3D-Printed-Granular-Jamming-Hand/3d-printed-granular-jamming-hand/GranularJammingModels/4nb7b.gif

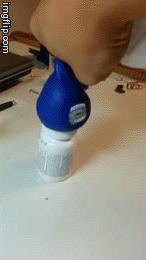
GranularJammingModels/4nb7b.gif
