3D-Printed-Granular-Jamming-Hand/3d-printed-granular-jamming-hand/README.txt

This is a student-driven project in which we develop a 3d printable hand prosthetic, utilizing granular jamming to maintain a firm grip on objects.
