3D-Printed-Granular-Jamming-Hand/3d-printed-granular-jamming-hand/Z OldResearch/Research/Arm Amputation Statistics/README.txt

Statistics on arm amputation-- for background.
