3D-Printed-Granular-Jamming-Hand/3d-printed-granular-jamming-hand/Z OldResearch/Research/Hobbyist Hands/README.txt

This folder contains research on hobbyist hand projects.

HOW TO NAVIGATE THIS FOLDER:

just check out "Hobbyist 3D Printed Hand Websites", and focus most on the 3 biggest players. That should be all you really need for a state-of-the-art analysis of current 3d printed hands.
