3D-Printed-Granular-Jamming-Hand/3d-printed-granular-jamming-hand/ProgressReports/1 Fall Semester/Presentation 1/Old Segments/Technical Analysis.pptx

## Technical Analysis

- Real hand motion
- 3 degrees of freedom
  - Supination/pronation
  - Extension/flexion
  - Ulnar deviation/radial deviation


## Technical Analysis

- 2 degrees of freedom
- Twist and extension/flexion

## Engineering Design

- Motors for fingers
- A digital I/O for signals from sensors and motors
- Granular jamming pad for firm grip

## Engineering Design

- Data when moving fingers
- Signals when moving wrist
- Signals when grabbing objects
