3D-Printed-Granular-Jamming-Hand/3d-printed-granular-jamming-hand/SolidworksModels/Forearm Models/Old/case model/update mar 12.docx

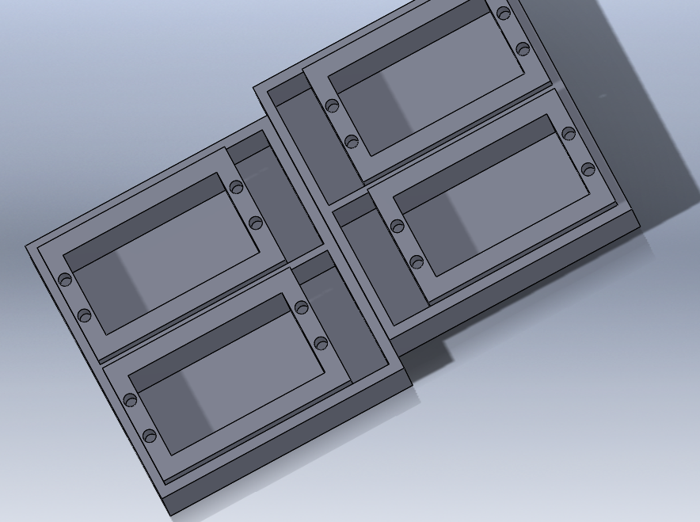
[picture p125: figure]

Servo case+mounting

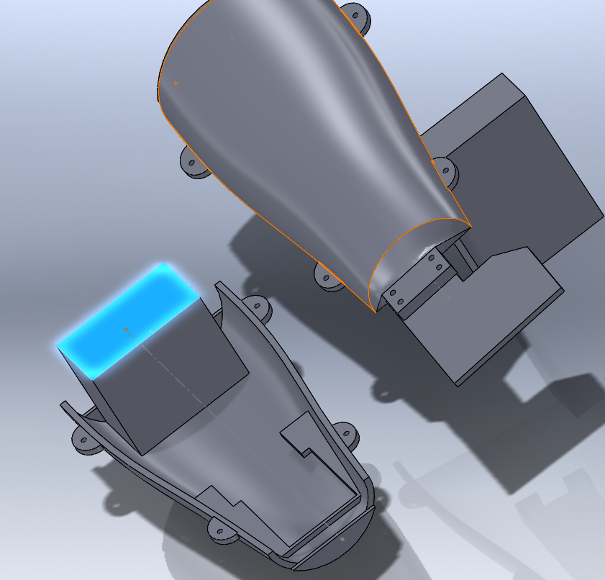
[picture p126: figure]

bottom and top
