3D-Printed-Granular-Jamming-Hand/3d-printed-granular-jamming-hand/Z OldResearch/Research/Air Muscle/Air Muscles.docx

Instructables on how to make an air muscle

http://www.instructables.com/id/How-to-make-air-muscles!/

Company who makes robotics using air muscle

http://www.shadowrobot.com/products/air-muscles/

Controlling a joint with 1 or 2 air muscles

https://www.youtube.com/watch?v=x6d1T210h9M&list=PL2dIrTE5UGCl7MQHjFtq9gGOiKrizbiVy

Screwing in a light bulb and unscrewing with air muscles

http://www.youtube.com/watch?v=dKHd2Wm_YyQ

Controlling an air muscle using EMG

https://www.youtube.com/watch?v=St9fjxKYR5g&list=PL2dIrTE5UGCl7MQHjFtq9gGOiKrizbiVy

https://www.youtube.com/watch?v=AkaVsoEd6Vo
