3D-Printed-Granular-Jamming-Hand/3d-printed-granular-jamming-hand/Z OldResearch/Research/Arm Amputation Statistics/prosthetic background.pptx

## Prosthesis: Definition

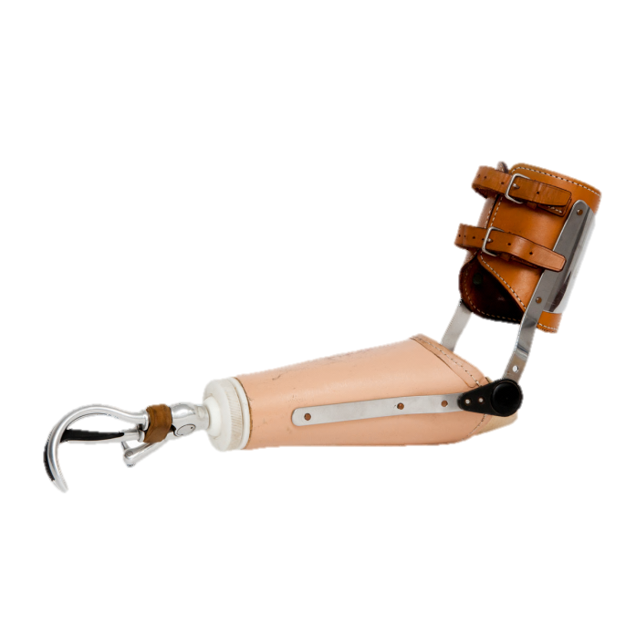
[picture p128: figure]

- An artificial device that replaces a missing body part
- These devices work with muscle, skeleton, and (more recently) the nervous system to enhance motor control
- Prosthetics can be used to replace a variety of body parts including but not limited to arms, legs, teeth, eyes, or heart valves

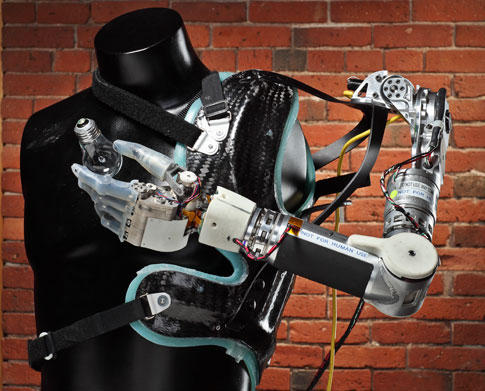
[picture p129: figure]

## History

- Prostheses date back to the ancient Egyptians and Greeks
  - Earliest mention of an artificial limb was around 500 B.C.
  - An artificial limb made of wood and copper dating back to 300 B.C. was found at Capri, Italy in 1858
  - During the Dark ages, debilitated knights would use prosthetics after losing limbs in battle.
- Functional prosthetics began to become introduced more and more with new developments of Ambroise Paré in amputation surgery in the 1500s.
  - Ambroise Paré , a French Army barber/surgeon, is considered the father of modern amputation surgery and prosthetic design.

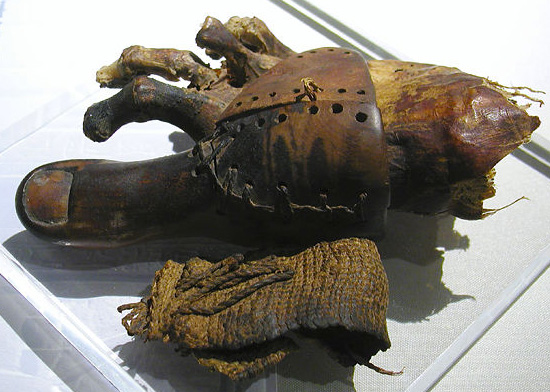
[picture p130: figure]

## History

- As time passed and technology became more advanced, prosthetics became more functional and intricate.

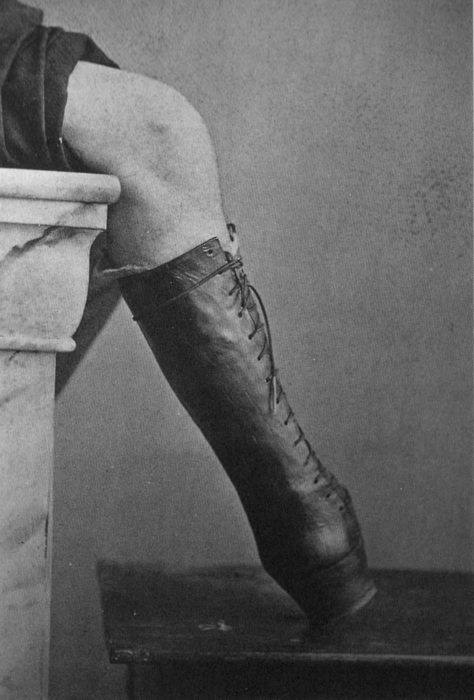
[picture p131: figure]
Prosthetic boot 1865
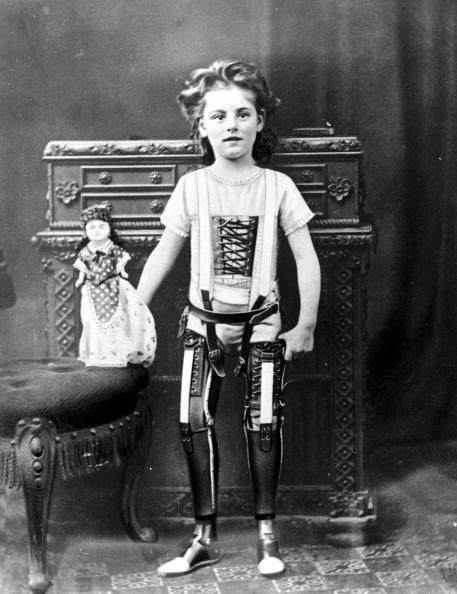
[picture p132: figure]
Studio photo of a young girl wearing a pair of artificial legs, ~ 1900. The legs were manufactured by James Gillingham, a boot- and shoemaker based in Chard, Somerset.
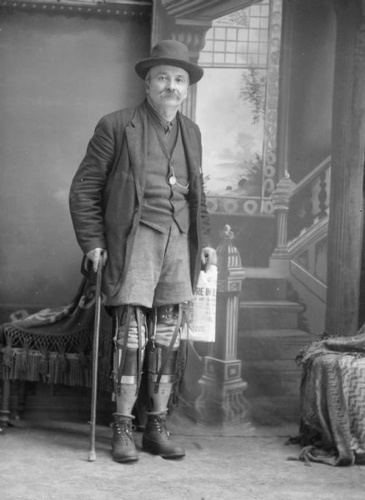
[picture p133: figure]
William Tennant with Prosthetic Legs by Wisconsin Historical Images, via Flickr

## Traditional Prosthesis

- Traditional prosthesis are not permanent
- They are attached to the body using a number of methods, all of which allow for easy removal
- The system of attachment is called the suspension system

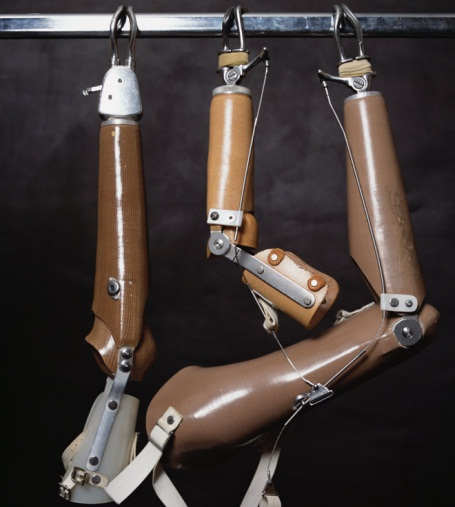
[picture p134: figure]
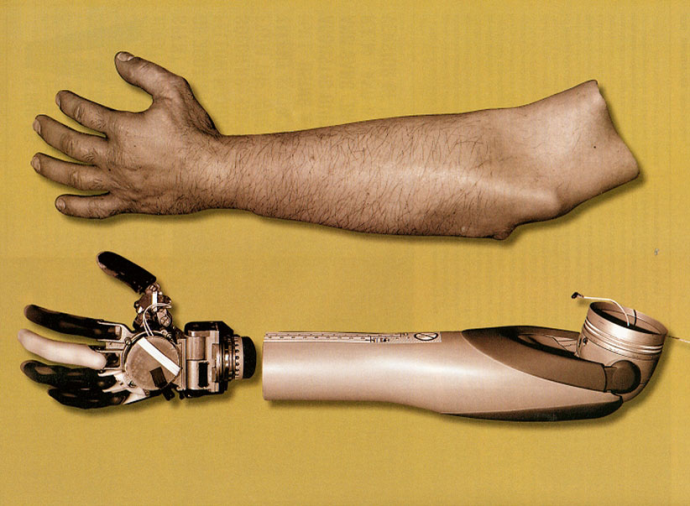
[picture p135: figure]
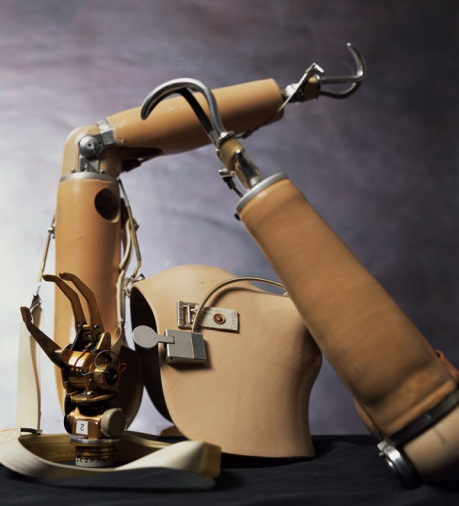
[picture p136: figure]

## Existing Suspension Systems

- Adjustable Sleeve
  - Achieves fit through a strap/buckle
  - Used in temporary situations, such as when the user’s body is adjusting to limb loss
- Elastic Sleeve
  - Sleeve covers the patient’s stump
  - Uses friction/slight vacuum to keep limb in place
  - Utilizes Silicone gel for a more comfortable fit
- Suction Socket
  - Creates vacuum between body and prosthesis
  - Artificial Limb can be taken on and off by opening a one-way valve
  - Better for blood flow

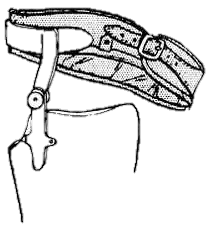
[picture p137: figure]
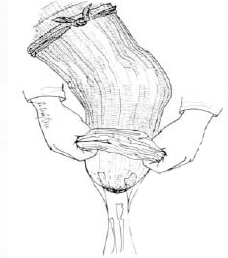
[picture p138: figure]
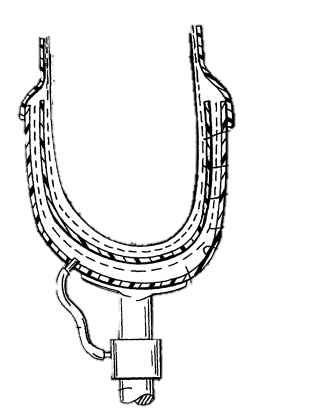
[picture p139: figure]

## Downside & Limitations of Traditional Prosthesis

- No direct connection to the body
  - There is no interface between human and limb
  - This means that complex control is impossible
- Waste of energy
  - It takes about 80% more energy to walk with an above the knee prosthetic than it takes for an able-bodied person
  - This makes walking very tiring
- Sweat causes irritation due to lack of airflow
  - This can cause skin rashes, blisters, and tissue breakdown
  - This irritation can also cause the stump to change size, changing fit
- Temporary
  - Traditional prosthetics have a short lifespan, and need to be replaced every few years
