3D-Printed-Granular-Jamming-Hand/3d-printed-granular-jamming-hand/ProgressReports/1 Fall Semester/Presentation 1/Old Segments/Matricies_CW.xlsx

Category: | Simplicity | Affordability | Feasability | Totals:
Category Weight: | 10 | 8 | 9
Item:
Balloon | 8 | 10 | 7 | 223
Silicone | 9 | 9 | 8 | 234
Category: | Simplicity | Affordability | Feasability | Totals:
Category Weight: | 10 | 8 | 9
Item:
Interconnected | 9 | 8 | 7 | 217
Individual | 5 | 6 | 3 | 125
Category: | Simplicity | Performance | Feasability | Totals:
Category Weight: | 10 | 9 | 9
Item:
Pad for 1 | 9 | 5 | 7 | 198
Pad for 1,2,&3 | 6 | 8 | 5 | 177
Pads on 1 & 3 | 8 | 7 | 7 | 206
