3D-Printed-Granular-Jamming-Hand/3d-printed-granular-jamming-hand/SCADModels/Purchased/README.txt

This folder contains all the models/keepaways/etc for parts that will be purchased and need to fit into the printed parts.
