3D-Printed-Granular-Jamming-Hand/3d-printed-granular-jamming-hand/SolidworksModels/Forearm Models/top.SLDASM

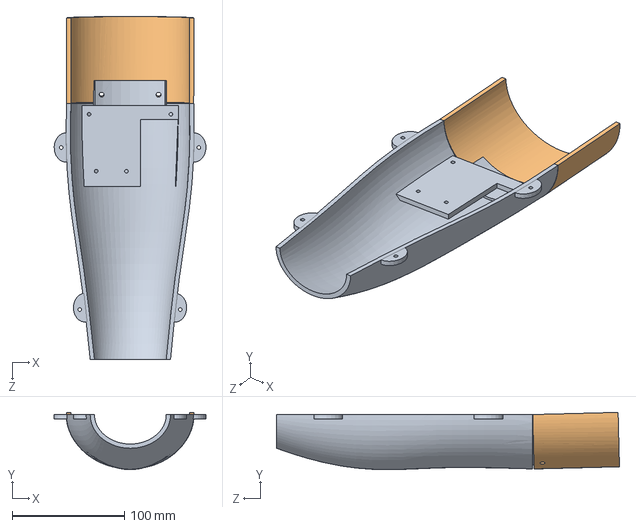
[picture p140: CAD file, 2014-05-27]
SolidworksModels/Forearm Models/top.SLDASM
135.4 x 51.1 x 306.0 mm
Top
Top1
