3D-Printed-Granular-Jamming-Hand/3d-printed-granular-jamming-hand/SolidworksModels/Forearm Models/Bottom.SLDASM

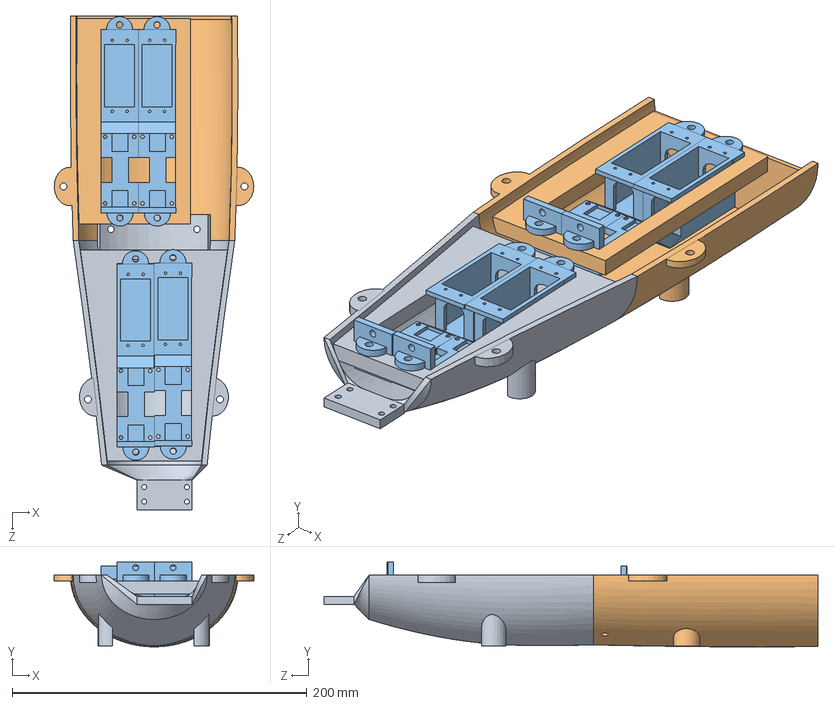
[picture p141: CAD file, 2014-05-27]
SolidworksModels/Forearm Models/Bottom.SLDASM
135.5 x 57.6 x 335.3 mm
bottom2
bottom
servo case x 4
