3D-Printed-Granular-Jamming-Hand/3d-printed-granular-jamming-hand/SolidworksModels/Servo Hubs/HubsAtRelativeHeights.SLDASM

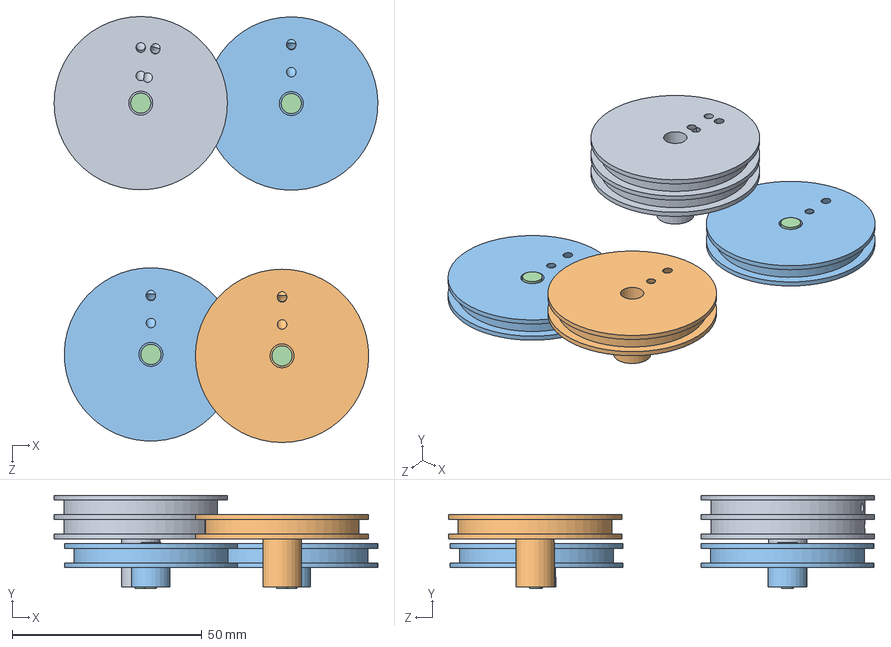
[picture p142: CAD file, 2014-05-09]
SolidworksModels/Servo Hubs/HubsAtRelativeHeights.SLDASM
85.4 x 24.6 x 112.4 mm
Hub3
Hub2
Hub1 x 2
ServoHubBolt x 4
