3D-Printed-Granular-Jamming-Hand/3d-printed-granular-jamming-hand/SCADModels/Printed/Hand8.0_fixed.stl

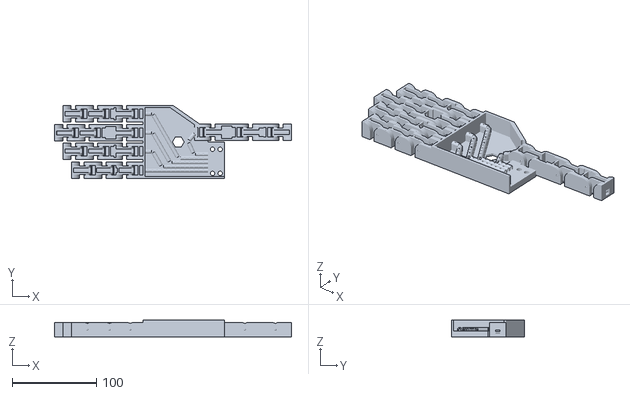
[picture p143: CAD file, 2014-05-09]
SCADModels/Printed/Hand8.0_fixed.stl
281.8 x 87.0 x 19.8
