3D-Printed-Granular-Jamming-Hand/3d-printed-granular-jamming-hand/SolidworksModels/Forearm Models/bottom2.SLDPRT

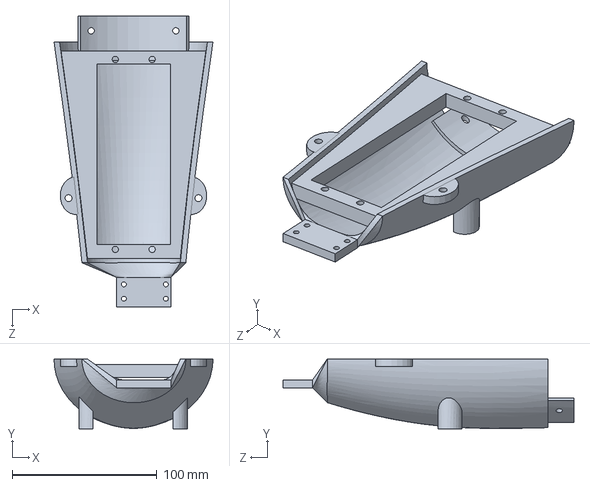
[picture p144: CAD file, 2014-05-27]
SolidworksModels/Forearm Models/bottom2.SLDPRT
109.7 x 48.3 x 200.7 mm
