3D-Printed-Granular-Jamming-Hand/3d-printed-granular-jamming-hand/SolidworksModels/Servo Hubs/Hub3-fixed.SLDPRT

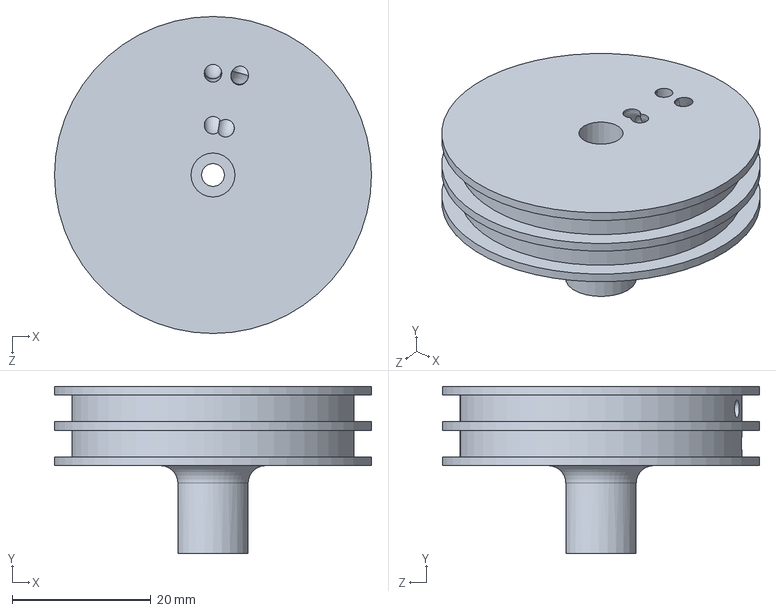
[picture p145: CAD file, 2014-05-27]
SolidworksModels/Servo Hubs/Hub3-fixed.SLDPRT
45.7 x 24.1 x 45.7 mm
