3D-Printed-Granular-Jamming-Hand/3d-printed-granular-jamming-hand/SolidworksModels/Servo Hubs/Hub1-fixed.SLDPRT

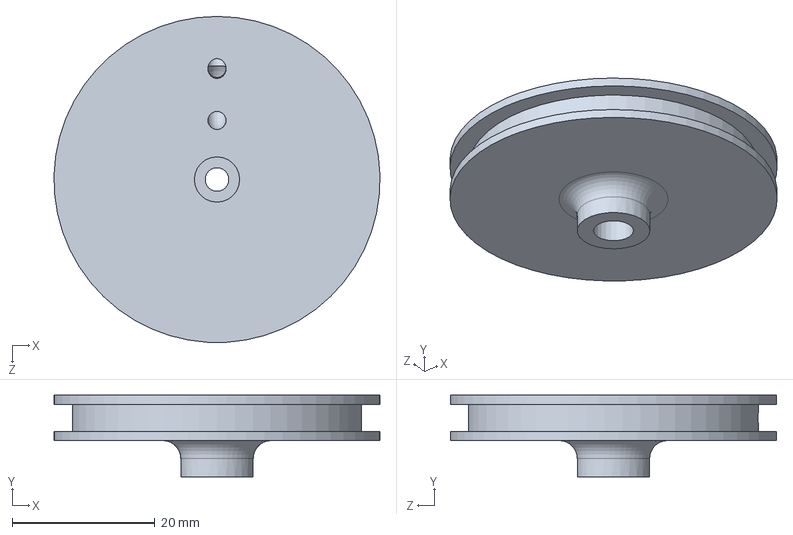
[picture p146: CAD file, 2014-05-27]
SolidworksModels/Servo Hubs/Hub1-fixed.SLDPRT
45.7 x 11.4 x 45.7 mm
