3D-Printed-Granular-Jamming-Hand/3d-printed-granular-jamming-hand/SolidworksModels/Forearm Models/Top1.SLDPRT

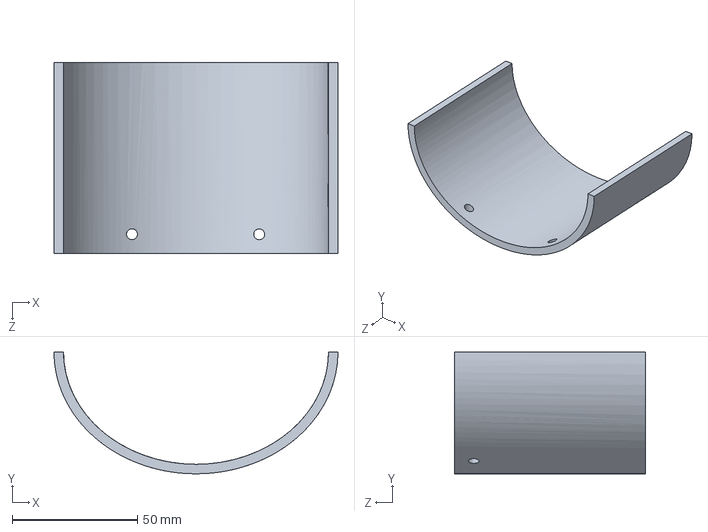
[picture p147: CAD file, 2014-05-27]
SolidworksModels/Forearm Models/Top1.SLDPRT
113.4 x 48.6 x 76.2 mm
