3D-Printed-Granular-Jamming-Hand/3d-printed-granular-jamming-hand/SolidworksModels/Servo Hubs/Hub2-fixed.SLDPRT

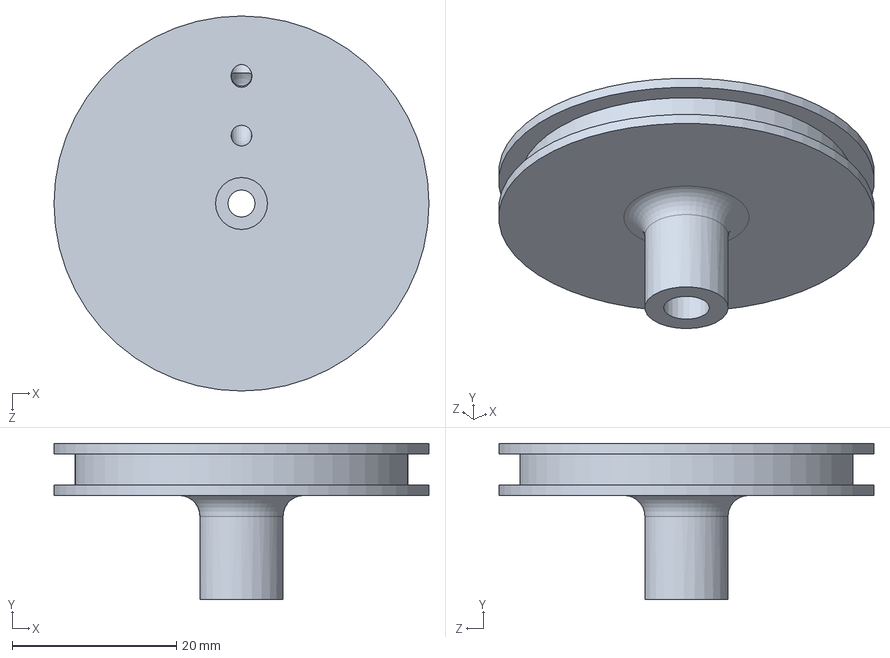
[picture p148: CAD file, 2014-05-27]
SolidworksModels/Servo Hubs/Hub2-fixed.SLDPRT
45.7 x 19.0 x 45.7 mm
