3D-Printed-Granular-Jamming-Hand/3d-printed-granular-jamming-hand/SolidworksModels/Forearm Models/servo case.SLDPRT

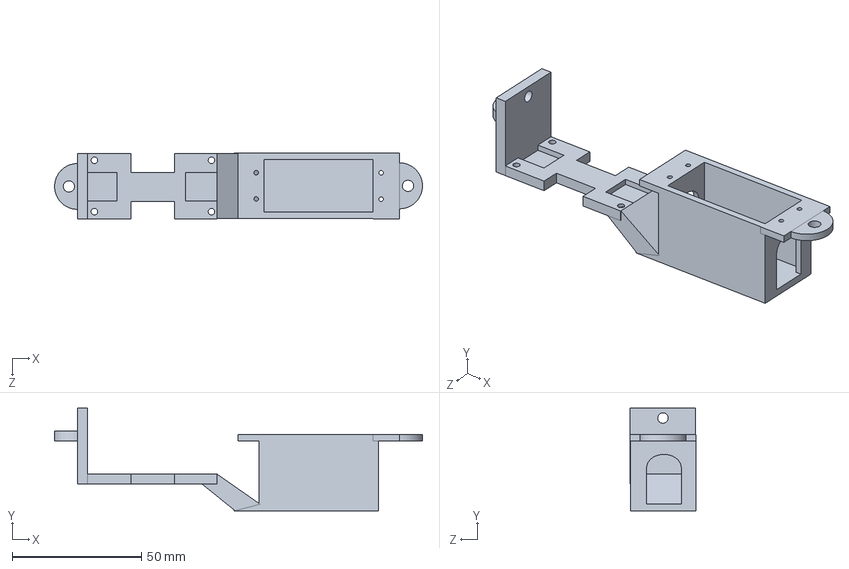
[picture p149: CAD file, 2014-05-27]
SolidworksModels/Forearm Models/servo case.SLDPRT
142.2 x 39.6 x 25.5 mm
