3D-Printed-Granular-Jamming-Hand/3d-printed-granular-jamming-hand/SCADModels/Purchased/ServoMotor.stl

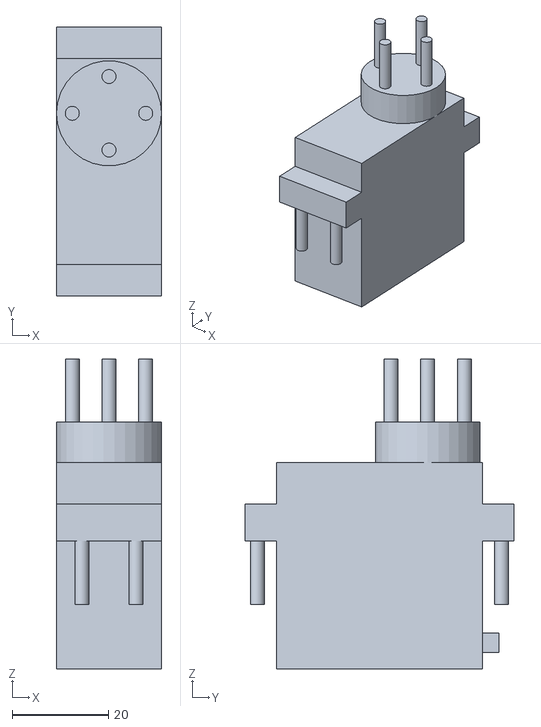
[picture p150: CAD file, 2014-03-25]
SCADModels/Purchased/ServoMotor.stl
21.8 x 55.8 x 64.3
