3D-Printed-Granular-Jamming-Hand/3d-printed-granular-jamming-hand/SCADModels/Purchased/STLS/RubberBand.stl

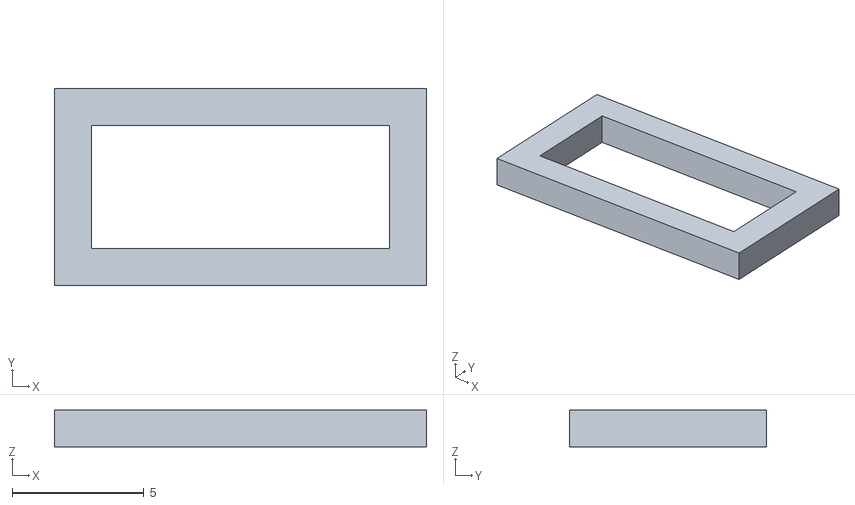
[picture p151: CAD file, 2014-01-30]
SCADModels/Purchased/STLS/RubberBand.stl
14.1 x 7.45 x 1.40
