3D-Printed-Granular-Jamming-Hand/3d-printed-granular-jamming-hand/SolidworksModels/Servo Hubs/ServoHubBolt.SLDPRT

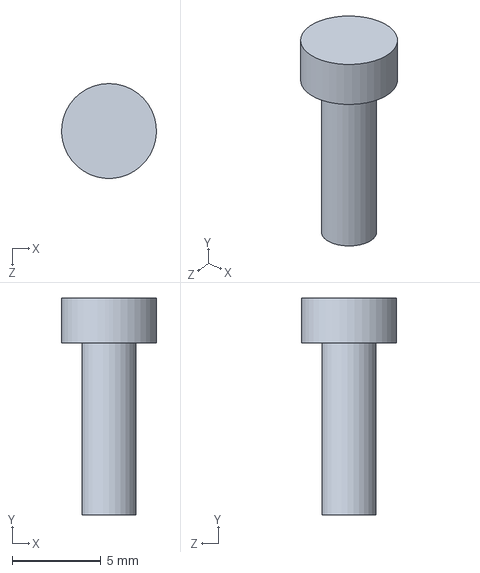
[picture p152: CAD file, 2014-05-09]
SolidworksModels/Servo Hubs/ServoHubBolt.SLDPRT
5.33 x 12.2 x 5.33 mm
