3D-Printed-Granular-Jamming-Hand/3d-printed-granular-jamming-hand/SolidworksModels/Forearm Models/Old/case model/Servo+sensor.SLDASM

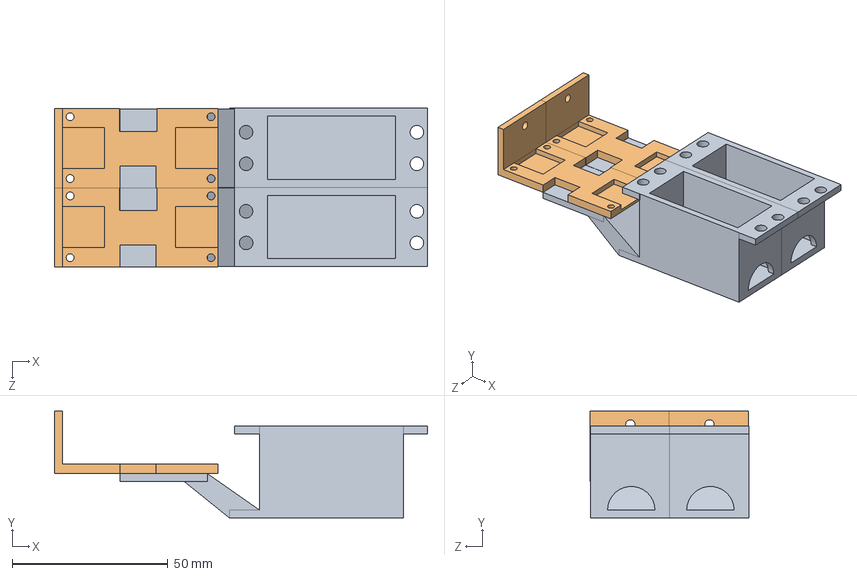
[picture p153: CAD file, 2014-05-27, an earlier design]
SolidworksModels/Forearm Models/Old/case model/Servo+sensor.SLDASM
119.8 x 34.3 x 51.0 mm
servo case x 2
sensor mounting x 2
