3D-Printed-Granular-Jamming-Hand/3d-printed-granular-jamming-hand/SolidworksModels/Z Old/MotorAndMount.SLDASM

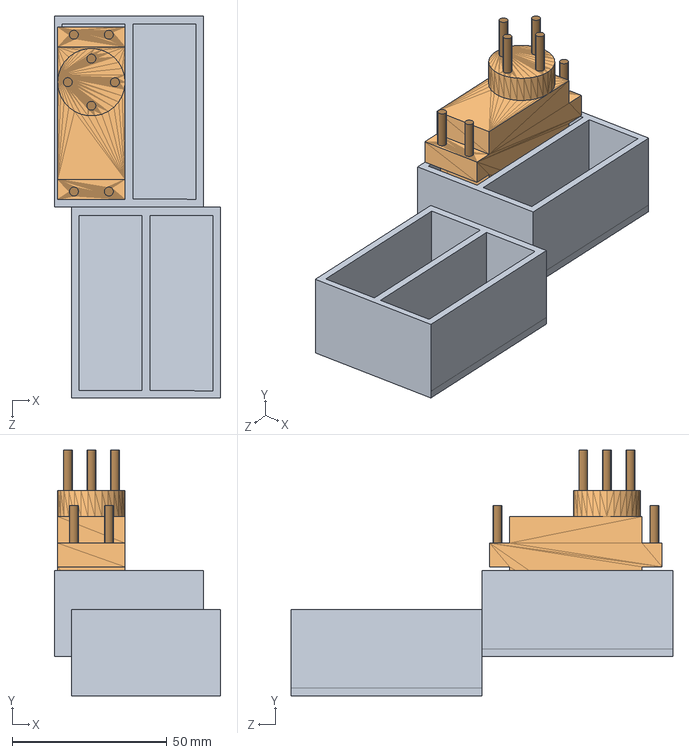
[picture p154: CAD file, 2014-05-09, an earlier design]
SolidworksModels/Z Old/MotorAndMount.SLDASM
53.8 x 79.5 x 123.4 mm
ServoMotor
