3D-Printed-Granular-Jamming-Hand/3d-printed-granular-jamming-hand/SolidworksModels/Z Old/Finger Assembly/FingerAssembly3.SLDASM

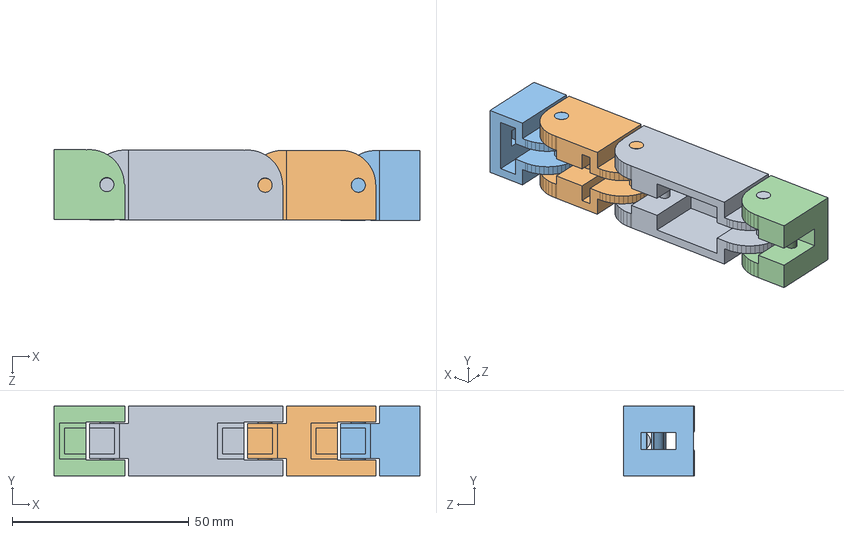
[picture p155: CAD file, 2014-01-30, an earlier design]
SolidworksModels/Z Old/Finger Assembly/FingerAssembly3.SLDASM
103.4 x 19.8 x 20.0 mm
fingerbase
fingermid
fingertip
negetivehinge
