3D-Printed-Granular-Jamming-Hand/3d-printed-granular-jamming-hand/SolidworksModels/Forearm Models/Old/case model/battery+bottom.SLDASM

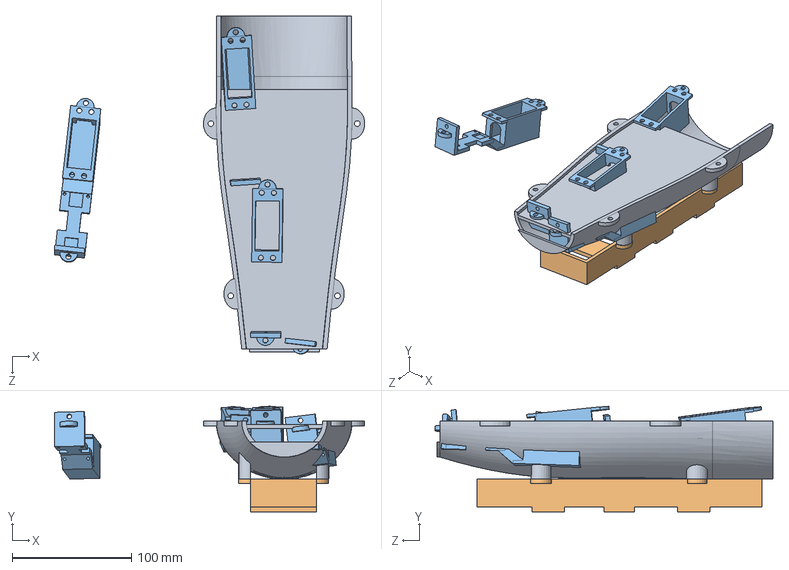
[picture p156: CAD file, 2014-05-27, an earlier design]
SolidworksModels/Forearm Models/Old/case model/battery+bottom.SLDASM
260.5 x 88.5 x 283.6 mm
bottom
battery mount
servo case x 4
