3D-Printed-Granular-Jamming-Hand/3d-printed-granular-jamming-hand/SCADModels/Tolerances/3dPrinterTolerance.scad

function 3dPrinterTolerance()=.4;
