3D-Printed-Granular-Jamming-Hand/3d-printed-granular-jamming-hand/SCADModels/Tolerances/PlasticWidth.scad

//all this does is store the width for the plastic shells of the fingers

function PlasticWidth() = 2.5;
