3D-Printed-Granular-Jamming-Hand/3d-printed-granular-jamming-hand/SCADModels/Printed/HandTest.scad

import("Hand4.0_fixed.stl");
