3D-Printed-Granular-Jamming-Hand/3d-printed-granular-jamming-hand/SCADModels/Tutorials/4 STL Tutorial.scad

//Let's say you want to make an STL!

//Open your .scad document, hit f6, click the design tab, and select "export as STL..."

//.scad files are the ones you edit, .stl files are what you export for printing!

//And that's honestly it, with these 4 tutorials you have all the building blocks you actually need to make parts. Everything else from here on out is just combining cylinders and cubes and doing union/difference operations.
