3D-Printed-Granular-Jamming-Hand/3d-printed-granular-jamming-hand/(list of files, cad)

Other CAD files:
SCADModels/Printed/Hand7.0_fixed.stl
SCADModels/Purchased/ServoWithHub.scad
SCADModels/Printed/IndexRing.scad
SCADModels/Printed/Mid.scad
SCADModels/Printed/Palm2.scad
SCADModels/Printed/Thumb.scad
SCADModels/Printed/Old/Finger Segment.stl
SCADModels/Printed/Old/Finger TEST.scad
SCADModels/Printed/Old/Finger TEST2.scad
SCADModels/Printed/Old/Finger TEST2.stl
SCADModels/Printed/Old/Finger TEST3.scad
SCADModels/Printed/Old/Finger TEST4.scad
SCADModels/Printed/Old/Finger.scad
SCADModels/Printed/Old/Finger.stl
SCADModels/Printed/Old/Finger2ForPrintstl.stl
SCADModels/Printed/Old/FingerForPrint.stl
SCADModels/Printed/Old/FingerForPrint_fixed.stl
SCADModels/Printed/Old/FingerIteration2_fixed.stl
SCADModels/Printed/Old/FingerMid.stl
SCADModels/Printed/Old/FingerTip.scad
SCADModels/Printed/Old/FingerTip.stl
SCADModels/Printed/Old/Finger_Iteration2.stl
SCADModels/Printed/Old/Finger_Spring_Semester.scad
SCADModels/Printed/Old/Finger_fixed.stl
SCADModels/Printed/Old/Fingerbase TEST.stl
SCADModels/Printed/Old/Fingermid TEST.stl
SCADModels/Printed/Old/Fingertip TEST.stl
SCADModels/Printed/Old/Hand.scad
SCADModels/Printed/Old/Hand4.0_fixed.stl
SCADModels/Printed/Old/Hand5.0_fixed.stl
SCADModels/Printed/Old/Hand7.0_fixed.stl
SCADModels/Printed/Old/Hand_fixed.stl
SCADModels/Printed/Old/HiToleranceHand_fixed.stl
SCADModels/Printed/Old/HiTolerance_Finger_Spring_Semester.scad
SCADModels/Printed/Old/IndexMiddleTest.scad
SCADModels/Printed/Old/IndexRing_Spring_Semester.scad
SCADModels/Printed/Old/LoToleranceHand_fixed.stl
SCADModels/Printed/Old/OtherFingerTip.stl
SCADModels/Printed/Old/Palm.scad
SCADModels/Printed/Old/Palm2.scad
SCADModels/Printed/Old/Palm3_repair_attempt.scad
SCADModels/Printed/Old/PinkyTest.scad
SCADModels/Printed/Old/Pinky_Spring_Semester.scad
SCADModels/Printed/Old/Thumb.scad
SCADModels/Printed/Old/ThumbTest.scad
SCADModels/Printed/Old/Thumb_Spring_Semester.scad
SCADModels/Printed/Old/negetivehinge.stl
SCADModels/Purchased/STLS/ServoMotor.stl
SolidworksModels/Forearm Models/Old/Pump.SLDPRT
SolidworksModels/Forearm Models/Old/ServoMotor.SLDPRT
SolidworksModels/Forearm Models/Old/Solenoid Valve.SLDPRT
SolidworksModels/Forearm Models/Old/battery mount.SLDPRT
SolidworksModels/Forearm Models/Old/case model/DoubleServoHub.stl
SolidworksModels/Forearm Models/Old/case model/Palm.stl
SolidworksModels/Forearm Models/Old/case model/Pump.STL
SolidworksModels/Forearm Models/Old/case model/Servo+sensor - sensor mounting-1.STL
SolidworksModels/Forearm Models/Old/case model/Servo+sensor - sensor mounting-2.SLDPRT
SolidworksModels/Forearm Models/Old/case model/Servo+sensor - sensor mounting-2.STL
SolidworksModels/Forearm Models/Old/case model/Servo+sensor - servo case-1.STL
SolidworksModels/Forearm Models/Old/case model/Servo+sensor - servo case-2.SLDPRT
SolidworksModels/Forearm Models/Old/case model/Servo+sensor - servo case-2.STL
SolidworksModels/Forearm Models/Old/case model/ServoHub.stl
SolidworksModels/Forearm Models/Old/case model/ServoMotor.SLDPRT
SolidworksModels/Forearm Models/Old/case model/Top.STL
SolidworksModels/Forearm Models/Old/case model/Top1.STL
SolidworksModels/Forearm Models/Old/case model/battery mount.STL
SolidworksModels/Forearm Models/Old/case model/bottom.STL
SolidworksModels/Forearm Models/Old/case model/bottom2.STL
SolidworksModels/Forearm Models/Old/case model/case+servo+sensor.SLDASM
SolidworksModels/Forearm Models/Old/case model/handmount2.SLDPRT
SolidworksModels/Forearm Models/Old/case model/potentiometer.SLDPRT
SolidworksModels/Forearm Models/Old/case model/sensor mounting.SLDDRW
SolidworksModels/Forearm Models/Old/case model/sensor mounting.SLDPRT
SolidworksModels/Forearm Models/Old/case model/servo case.SLDDRW
SolidworksModels/Forearm Models/Old/case model/servo casex4.STL
SolidworksModels/Forearm Models/Old/case model/solenoid.SLDPRT
SolidworksModels/Forearm Models/Old/case model/top pump mount.STL
SolidworksModels/Forearm Models/Old/top pump mount.SLDPRT
SolidworksModels/Forearm Models/Top.SLDPRT
SolidworksModels/Forearm Models/Top.STL
SolidworksModels/Forearm Models/Top1.STL
SolidworksModels/Forearm Models/bottom.SLDPRT
SolidworksModels/Forearm Models/bottom.STL
SolidworksModels/Forearm Models/bottom2.STL
SolidworksModels/Forearm Models/servo case.STL
SolidworksModels/Servo Hubs/Hub1-fixed.STL
SolidworksModels/Servo Hubs/Hub2-fixed.STL
SolidworksModels/Servo Hubs/Hub3-fixed.STL
SolidworksModels/Servo Hubs/Old/Hub1-frankenmotor.SLDPRT
SolidworksModels/Servo Hubs/Old/Hub1-frankenmotor.STL
SolidworksModels/Servo Hubs/Old/Hub1.SLDPRT
SolidworksModels/Servo Hubs/Old/Hub1.STL
SolidworksModels/Servo Hubs/Old/Hub2.SLDPRT
SolidworksModels/Servo Hubs/Old/Hub2.STL
SolidworksModels/Servo Hubs/Old/Hub3.SLDPRT
SolidworksModels/Servo Hubs/Old/Hub3.STL
SolidworksModels/Z Old/Finger Assembly/fingertip.SLDPRT
SolidworksModels/Z Old/Finger Assembly/negetivehinge.SLDPRT
SolidworksModels/Z Old/Finger Segment Studies/FingerTipStudy.SLDPRT
SolidworksModels/Z Old/Part7.SLDPRT
SolidworksModels/Z Old/Rubber Band Study/RubberBand.SLDPRT
