3D-Printed-Granular-Jamming-Hand/3d-printed-granular-jamming-hand/SCADModels/Printed/README.txt

This folder contains all of the parts that comprise the hand and will be 3d printed.
