3D-Printed-Granular-Jamming-Hand/3d-printed-granular-jamming-hand/SCADModels/Tutorials/README.txt

Simple tutorials to teach group members SCAD basics.
