3D-Printed-Granular-Jamming-Hand/3d-printed-granular-jamming-hand/Z OldResearch/Research/3d Printing/README.txt

This folder contains research on 3d printing.
