3D-Printed-Granular-Jamming-Hand/3d-printed-granular-jamming-hand/Z OldResearch/Research/Granular Jamming/Hand Prints.docx

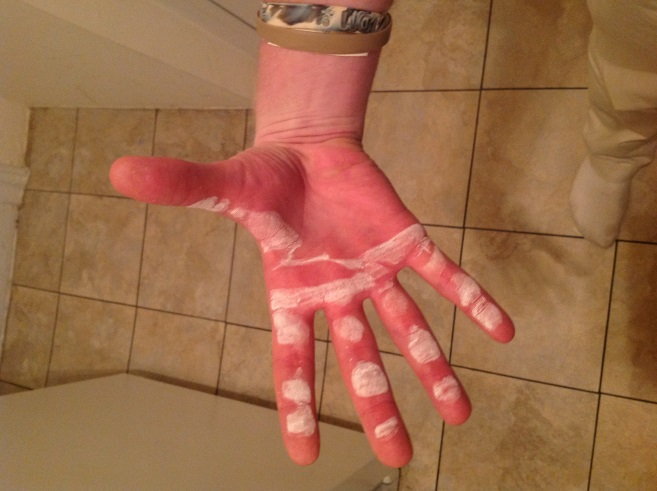
[picture p162: figure]

Hand After Grabbing Fridge Door Handle

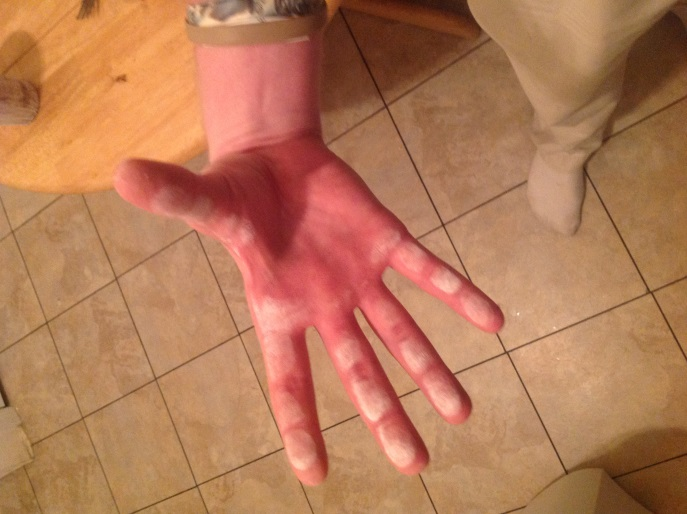
[picture p163: figure]

Prints from Picking up cup

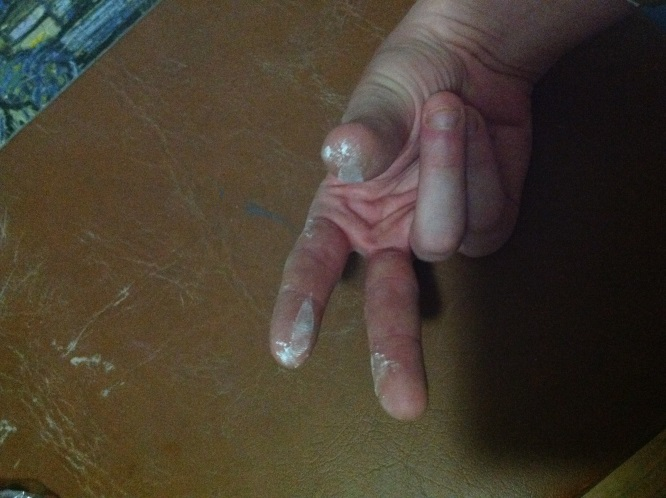
[picture p164: figure]

Chalk Print from holding Pencil

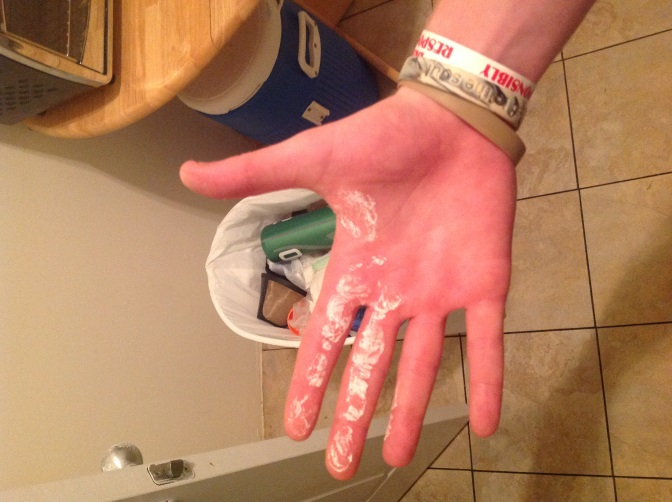
[picture p165: figure]

Door Knob
