3D-Printed-Granular-Jamming-Hand/3d-printed-granular-jamming-hand/Z OldResearch/Research/Hobbyist Hands/Hobbyist 3D Printed Hand Websites.docx

Hobbyist 3D Printed Hands (links to official websites/thingiverse pages):

The Three Big Leaders:

Robohand (finger prosthetic created for children suffering from amniotic band syndrome)

Websites:

http://robohand.net/

http://www.robohand.blogspot.ca/

https://www.facebook.com/pages/Robohand/260864887366912?ref=ts&fref=ts

Thingiverse:

http://www.thingiverse.com/thing:44150

InMoov (part of a humanoid robot—not meant as a prosthetic)

Website:

http://inmoov.blogspot.com/

Thingiverse:

http://www.thingiverse.com/thing:17773

Open Hand Project (complete hand prosthetic):

Websites:

http://techcrunch.com/2013/09/05/the-dextrus-robotic-hand-wants-to-make-advanced-prosthetics-100x-cheaper-via-3d-printing/

http://www.openhandproject.org/

http://www.indiegogo.com/projects/the-open-hand-project-a-low-cost-robotic-hand

https://www.facebook.com/theopenhandproject

(no thingiverse page)

Other things of interest:

This kid made a hand/arm prosthetic:

http://www.gizmag.com/easton-lachappelle-3d-printed-prosthetic/28685/

Here is an entire blog on making open source prosthetics:

http://openprosthetics.org
