3D-Printed-Granular-Jamming-Hand/3d-printed-granular-jamming-hand/Z OldResearch/Research/3d Printing/Things to Further Research.docx

Look into Polycarbonate printing, since polycarbonate is so strong.

http://reprap.org/wiki/Polycarbonate

https://www.lulzbot.com/?q=products/polycarbonate-3mm-filament-1kg-reel
