3D-Printed-Granular-Jamming-Hand/3d-printed-granular-jamming-hand/GranularJammingModels/GRANULAR JAMMING TESTS.pptx

## Granular Jamming Testing

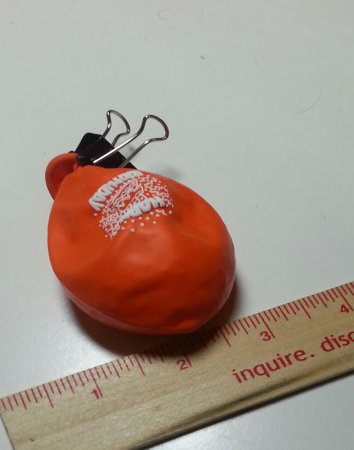
[picture p194: figure]
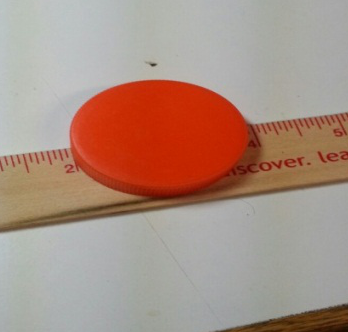
[picture p195: figure]
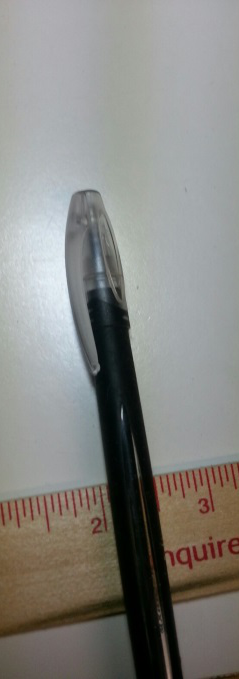
[picture p196: figure]
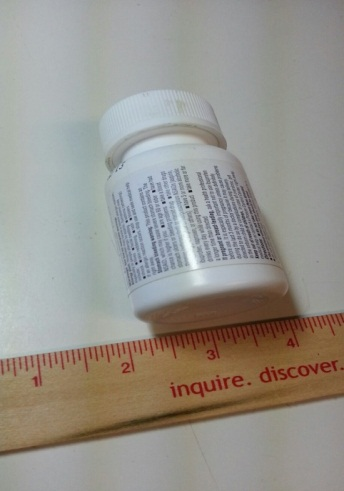
[picture p197: figure]
