3D-Printed-Granular-Jamming-Hand/3d-printed-granular-jamming-hand/(commit log)

2013-09-04 Started a couple SCAD models
    [3dPrinterTolerance.scad, FingerTip.scad, RubberBand.scad]
2013-09-18 Gantt chart, research, tasklist, & brainstorming
    [RubberBand.scad]
2013-09-19 Made SCAD tutorials
    [1 Basic Tutorial.scad, 2 Cutout Tutorial.scad, 3 Boolean Tutorial.scad, 4 STL Tutorial.scad, ServoMotor.scad, ServoMotor.stl]
2013-09-23 Maggie's Slides
    [1 Basic Tutorial.scad, 2 Cutout Tutorial.scad, 3 Boolean Tutorial.scad, 3dPrinterTolerance.scad, 4 STL Tutorial.scad, FingerTip.scad, RubberBand.scad, ServoMotor.scad]
2013-09-23 Bill of Materials updated
    Excel format, will add granular jamming tonight :)
    [Bill of Materials.xlsx]
2013-09-23 Combined all the powerpoint segments
2013-09-23 My Decision Matricies?
    [Matricies_CW.xlsx]
2013-09-24 Chalk Print Marks
    Will send videos too
2013-09-24 Added Sean's BOM, updated PPT
    [Updated Bill of materials.xlsx]
2013-09-25 updated sean's bill of materials, ppt
    [Updated Bill of materials.xlsx]
2013-09-28 Added more material/answered questions
    Could use some editing still
2013-10-09 added thesis on granular jamming
    [1 Basic Tutorial.scad, 2 Cutout Tutorial.scad, 3 Boolean Tutorial.scad, 3dPrinterTolerance.scad, 4 STL Tutorial.scad, FingerTip.scad, PlasticWidth.scad, RubberBand.scad]
2013-10-21 Completed rough finger/hand model
    [Finger.SLDPRT, Finger.scad, Finger.stl, Finger_fixed.stl, Palm.scad, Thumb.scad]
2013-10-22 Made dedicated "Hand" file
    [Hand.scad, Palm.scad]
2013-11-05 Solidworks Files
    [Finger Segment.stl, Finger.SLDPRT, Finger.scad, FingerAssembly3.SLDASM, FingerForPrint.stl, FingerForPrint_fixed.stl, FingerMid.stl, FingerTip.stl]
2013-11-06 Made majority of the PowerPoint presentation
    [Bearing.scad, Finger TEST.scad, Finger.scad, FingerAssembly3.SLDASM, FingerTipStudy.SLDPRT, Finger_Iteration2.stl, RubberBand.SLDPRT, RubberBand.scad]
2013-11-06 Moved PowerPoint to a dedicated folder
2013-11-07 updated phase 2 slideshow
    [FingerIteration2_fixed.stl]
2013-11-18 modifying fingers
    [Finger TEST.scad, Fingerbase TEST.stl, Fingermid TEST.stl, Fingertip TEST.stl]
2013-11-20 finished modifying fingers
    [Finger TEST2.scad, Finger TEST2.stl]
2013-11-25 uploaded my and chris' report segments
    [Finger TEST3.scad, Finger2ForPrintstl.stl]
2013-12-02 Uploaded a my second report segment
    [Finger TEST2.scad]
2014-01-23 hand updates
    [Finger TEST4.scad, Finger_Spring_Semester.scad, Hand.scad, IndexMiddleTest.scad, Palm.scad, PinkyTest.scad, ThumbTest.scad]
2014-01-25 Organized GIT
    [Bill of Materials.xlsx, Finger_Spring_Semester.scad, Matricies_CW.xlsx, Updated Bill of materials.xlsx]
2014-02-04 Completed Hand Prototype
    [Finger_Spring_Semester.scad, Hand.scad, Hand_fixed.stl, High_Low_Screw_As_Bolt.scad, IndexRing_Spring_Semester.scad, Palm.scad, Palm2.scad, Palm3.scad]
2014-02-11 Updated Report (Still have to update part names)
    [HiToleranceHand_fixed.stl, HiTolerance_Finger_Spring_Semester.scad, HiTolerance_Hand.scad, HiTolerance_Index_Ring_Spring_Semester.scad, HiTolerance_Mid_Spring_Semester.scad, HiTolerance_Pinky_Spring_Semester.scad, HiTolerance_Thumb_Spring_Semester.scad, IndexRing_Spring_Semester.scad]
2014-03-04 comitting everything before overhaul
    [Hand.scad, Hand4.0_fixed.stl, HiTolerance_Hand.scad, HiTolerance_Index_Ring_Spring_Semester.scad, HiTolerance_Mid_Spring_Semester.scad, HiTolerance_Pinky_Spring_Semester.scad, HiTolerance_Thumb_Spring_Semester.scad, IndexRing_Spring_Semester.scad]
2014-03-04 Overhauled (everything is MUCH more organized)
    [Bearing.scad, Finger Segment.stl, Finger TEST.scad, Finger TEST2.scad, Finger TEST2.stl, Finger TEST3.scad, Finger TEST4.scad, Finger.scad]
2014-03-25 New Hand (Ready To Print)
    [Hand4.0_fixed.stl, Hand5.0_fixed.stl, HandTest.scad, Mid.scad, Palm.scad, Palm.stl, ServoMotor.stl, ServoWithHub.scad]
2014-04-03 Set screw support, thumb guide update
    [CommonModules.scad, Hand5.0_fixed.stl, Hand7.0_fixed.stl, IndexRing.scad, Mid.scad, Palm.scad, Palm2.scad, Pinky.scad]
2014-05-09 phase 6 presentation updates
    [FingerAssembly3.SLDASM, FingerTipStudy.SLDPRT, RubberBand.SLDPRT, fingertip.SLDPRT, negetivehinge.SLDPRT]
2014-05-09 added servo hubs
    [Hub1-fixed.SLDPRT, Hub1-fixed.STL, Hub1-frankenmotor.SLDPRT, Hub1-frankenmotor.STL, Hub1.SLDPRT, Hub1.STL, Hub2-fixed.SLDPRT, Hub2-fixed.STL]
2014-05-09 updated hand .stl file
    [Hand7.0_fixed.stl, Hand8.0_fixed.stl]
2014-05-24 Arduino Code
2014-05-27 Updated forearm for summer project
    [Bottom.SLDASM, DoubleServoHub.stl, FingerAssembly3.SLDASM, FingerTipStudy.SLDPRT, Hub1-fixed.SLDPRT, Hub1-fixed.STL, Hub1-frankenmotor.SLDPRT, Hub1-frankenmotor.STL]
2014-05-27 whoops forgot the updated servo case .stl file
    [servo case.STL]
2014-07-03 Made a mini servo vitamin
    [Bill of Materials.xlsx, Hand.scad, Updated Bill of materials.xlsx]
